lwa-project/zcu102_timing_monitor/(commit log)

2025-08-25 Add files via upload
    Kicad design files and ino Arduino script for the XIAO SAMD21 module.
    [TimingMonitor.kicad_sch]
2025-10-22 Updated for the latest version (2.4a).
    [TimingMonitor.kicad_pcb, TimingMonitor.kicad_sch]
2025-10-23 Clean up command case handling.
2025-10-24 Fix Valon LCK/GND pins.
    [TimingMonitor.kicad_pcb, TimingMonitor.kicad_sch]
2025-10-24 And fix the labeling on the PCB as well.
    [TimingMonitor.kicad_pcb]
2025-11-06 Trade out footprints and update the regulator output voltage.
    [TimingMonitor.kicad_pcb, TimingMonitor.kicad_sch]
2025-11-06 Add in brown out detection and reading the MCU temperature.
    [timing_monitor.ino]
2025-11-06 Ignore some KiCAD files.
2025-11-07 Add LED and Valon cable info.
    [TimingMonitor.kicad_sch]
2025-11-07 Update the value of R30.
    [TimingMonitor.kicad_pcb, TimingMonitor.kicad_sch]
2025-11-20 Fix Valon port footprint.
    [TimingMonitor.kicad_pcb, TimingMonitor.kicad_sch]
